Roboy/tss18-Stronger-Hand/README.md

# tss18-Stronger-Hand
This is the repository for the Bachelor Thesis of the Stronger Hand (Gripper)
