Roboy/tss18-Stronger-Hand/docs/SS18-StrongerHand-211218-1420.pdf

# Stronger Hand

## Requirements:

Global Goals:

Functional Grasping with moderate Dexterity ( more than only one mode of open-close)

High Grasping Force: should be able to carry things up to 10 kg

Compact design for the Gripper as a possible endeffector for Roboy

Requirements from the Roboy Project:

Usage of Electromotors for Actuation

Actuation transmission: Tendon-driven

Method: Iterative rapide Ptototyping with of the shelf components for saving time and money

3D Prinitng of the components

Time Constraint: 6 Months

## Inspirationen- State of the Art:

Comparison of Robotic Grippers | Examples
anthropomorphic research hands | underactuated | Design of a highly biomimetic anthropomorphic robotic hand towards artifical limb regeneration (Xu und Todorov) CATCH-919 Hand: (Zhang et al) Unipi Hand (Catalano) Pisa IIT/ Soft hand (Catalano) Pisa Soft IIT/ Soft Hand 2 (Santina)
| fully actuated | Awiwi-Hand (Grebenstein) Utah/ MIT Dextrous Hand (Jacobsen) DLR Hand 2 (Butterfass) Shadow Hand
anthropomorphic prostehtic hands underactuated | mostly underactuated full | Cyberhand (Carrozza) SPRING Hand (Carrozza) Towards the design of a prosthetic hand ( Laliberté)
| fully actuated | Otto Bock myoelectrics hand
industrial grippers | underactuated | SDM Hand ( Dollar and Howe) i-HY Hand (Odhner) modular open source 3D printed underactuated hand (Ma) Barret Hand Grasper (Townsend)
Concepts for Hand Design | Different possibilitys

actuation unit | location of actuator | Extrinic: Forearm intrinsic: Self-contained
| actuation mechanism | Pneumatic actuation Electromotors ....
| Number of Actuators: DOA | high Number: high "Dexterity vs high complexity and buly design low number: low "dexterity " vs. compact and easy controlable design
number of DOF to number of DOA | | DOA<DOF: underactuated: passive joints DOA=DOF: fully actuated: active joints
way of actuation transmission | Joints | mechanical joints anthropomorphic joints elastic couplings
| Actuation transmission | tendon-driven: for fully actuation and underactuation linkage: for underactuation motor-driven: for fully actuation

## From Global Goals to technical Requirements- Modelling of the physical Systems as a basis for the design process and evaluation:

## Kinematik-Modellierung:

From complex 21 DOF Modell to.....

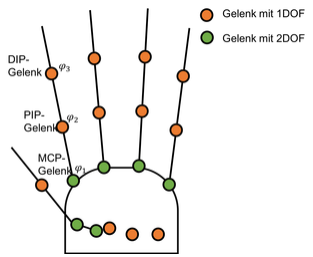
[picture p12: figure]

Functional Workspace: Optimized Taxonomy

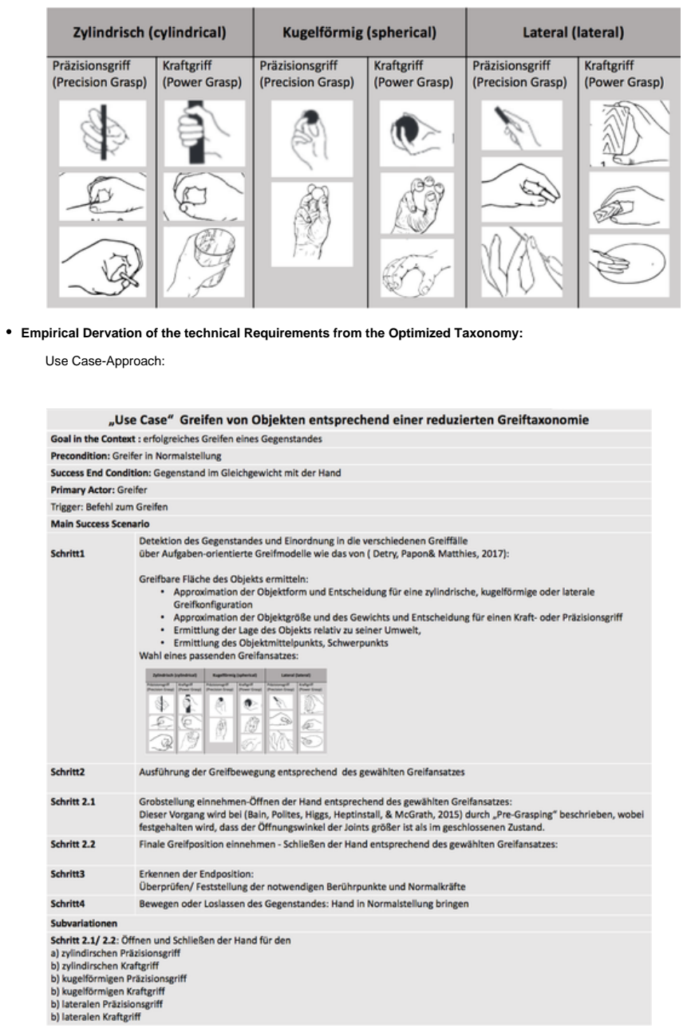
[picture p13: page 3]

Empirical Dervation of the technical Requirements from the Optimized Taxonomy:

Use Case-Approach:

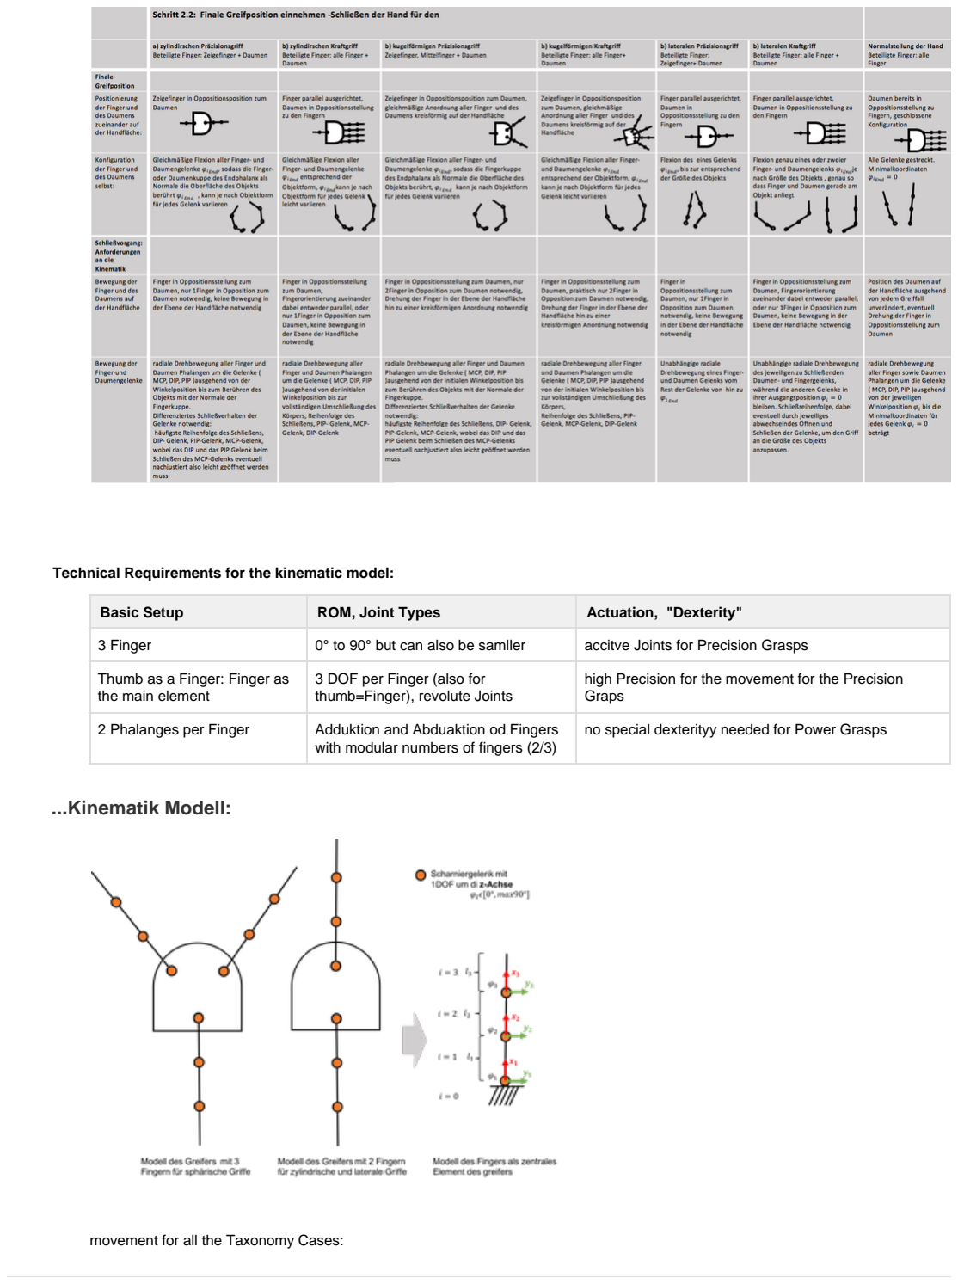
[picture p14: page 4]

Technical Requirements for the kinematic model:

Basic Setup | ROM, Joint Types | Actuation, "Dexterity"
3 Finger | 0° to 90° but can also be samller | accitve Joints for Precision Grasps
Thumb as a Finger: Finger as the main element | 3 DOF per Finger (also for thumb=Finger), revolute Joints | high Precision for the movement for the Precision Graps
2 Phalanges per Finger | Adduktion and Abduaktion od Fingers with modular numbers of fingers (2/3) | no special dexterityy needed for Power Grasps

## ...Kinematik Modell:

movement for all the Taxonomy Cases:

lateral Precision Grasp | lateral Power Grasp | cylindircal Precision Gras

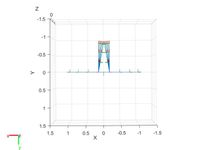
[picture p15: figure]

## Dynamik-Modellierung:

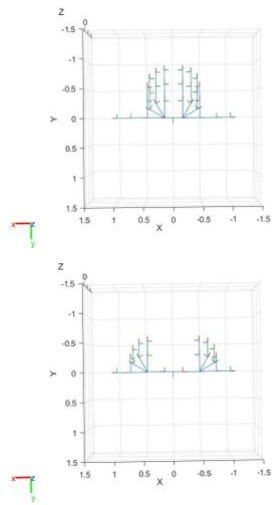
[picture p16: figure]

## Dynamical Modell of applying external Forces:

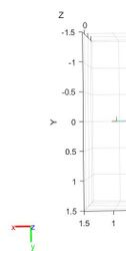
[picture p17: figure]
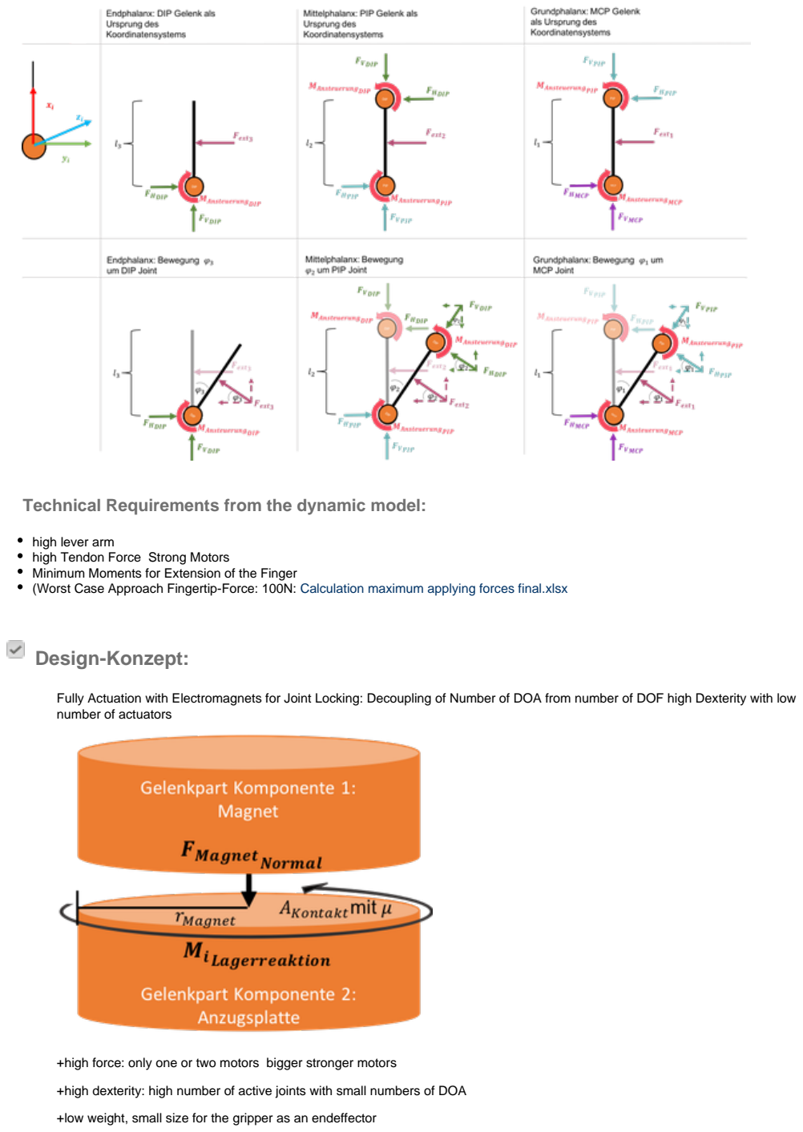
[picture p18: page 6]

## Technical Requirements from the dynamic model:

high lever arm
high Tendon Force Strong Motors
Minimum Moments for Extension of the Finger
(Worst Case Approach Fingertip-Force: 100N: Calculation maximum applying forces final.xlsx (https://devanthro.atlassian.net/wiki/download/attachments/260309073/Calculation%20maximum%20applying%20forces%20final.xlsx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)

## Design-Konzept:

Fully Actuation with Electromagnets for Joint Locking: Decoupling of Number of DOA from number of DOF high Dexterity with low number of actuators

+high force: only one or two motors bigger stronger motors

+high dexterity: high number of active joints with small numbers of DOA

+low weight, small size for the gripper as an endeffector

## Mathematical Modell: More Components Systems with Forces and Moments acting on it:

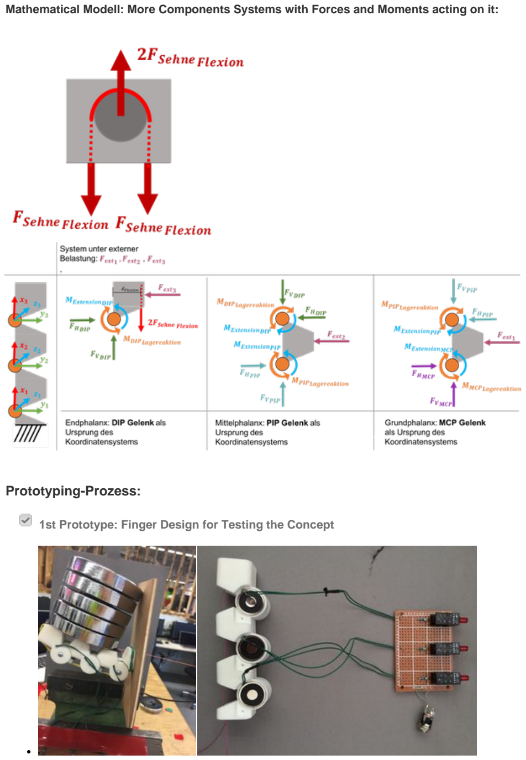
[picture p19: page 7]

## Prototyping-Prozess:

## 1st Prototype: Finger Design for Testing the Concept

CAD Path: Master Student Projects 18-18SS Stronger Hand 1_Prototyp 1
Prototyp 1-Dokumentation.docx (https://devanthro.atlassian.net/wiki/download/attachments/280559848/Prototyp%201-Dokumentation.docx?version=1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)

## 2nd Prototype: Imprvement of Finger Design and development of Gripper Design:

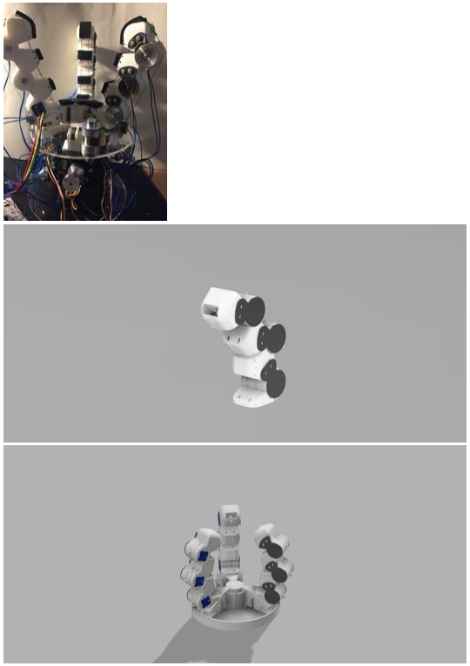
[picture p20: figure]

CAD Path: Master Student Projects 18-18SS Stronger Hand 2_Prototyp 2 Finger Mit Platte
Zweiter Prototyp.docx (https://devanthro.atlassian.net/wiki/download/attachments/280559848/Zweiter%20Prototyp.docx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)

Test Bench for Evaluation of the 2nd Prototype : Software, Electronics and Mechanical Hardware

## Design for Actuating the Gripper and getting Data from it

CAD Path: Master Student Projects 18-18SS Stronger Hand Test Bench Git repository: Stronger Hand

Test Bench_Evaluierung des Greifers.docx (https://devanthro.atlassian.net/wiki/download/attachments/280559848/Test%20Bench_Evaluierung%20des%20Greifers.docx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)

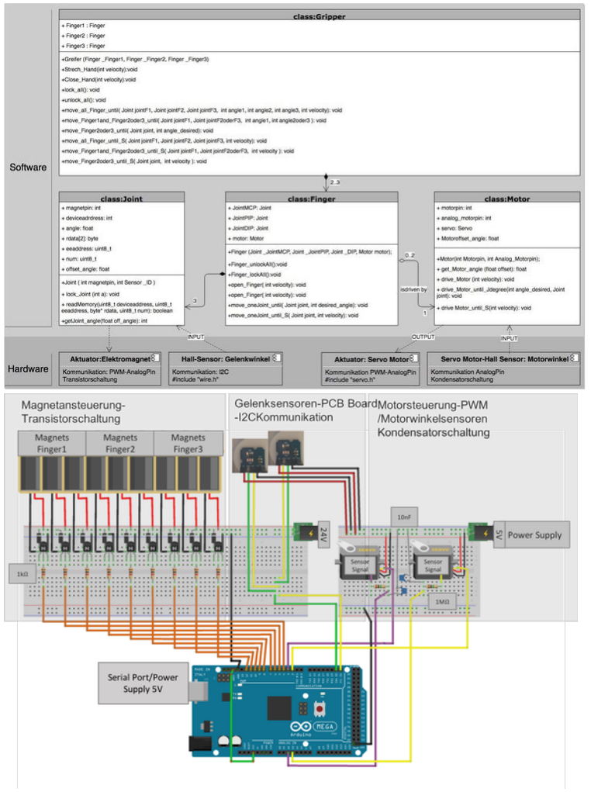
[picture p21: figure]

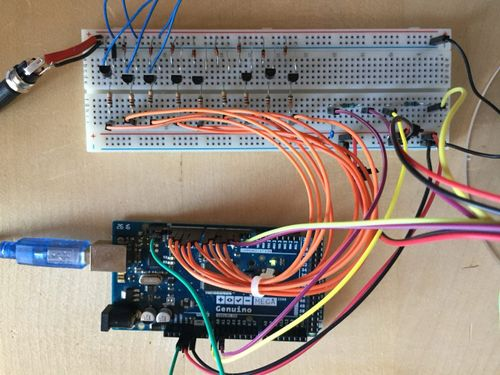
[picture p22: figure]

BOM-Maintenance _Final Version 08.10.2018.xlsx (https://devanthro.atlassian.net/wiki/download/attachments/259784776/BOM-Maintenance%20_Final%20Version%2008.10.2018.xlsx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)

# Final Evaluation

Verfiacation | Validation
| Finger

## Validation Gripper

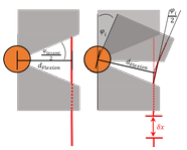
[picture p23: figure]

1.
2.

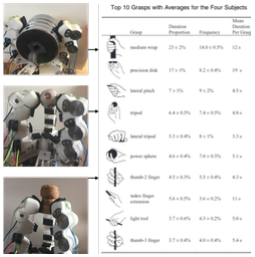
[picture p24: figure]

1.

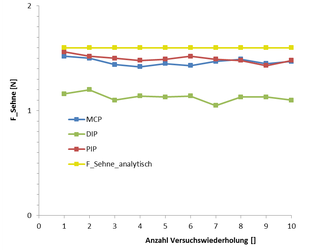
[picture p25: figure]

1.
2.
Precision of Movement Transmission: | Validation of the kinematics against the Taxonomy

Validation of the Grasping Performace ( Kinematics)

Against Taxonomy
Against Taxonomy from (Bullock)

Against a Set of Objects from the FFP Index from (Sureshbabu)

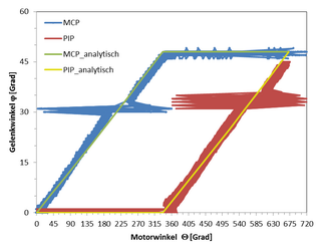
[picture p26: figure]

Precision of Force Transmission | Validation of the Fingertip Force against the Dynamic Modell

Validation of the Maximun Force of the Gripper (Kinetics)

Cylindircal Power Grasp 7kg
Spherical Power Graps 6kg

Electromagnets Mechanism-

Maximum Moment which can be applied on the System for keeping the Joint lockes

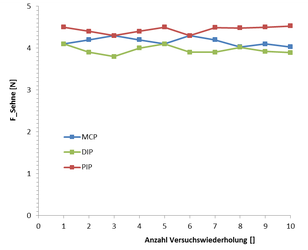
[picture p27: figure]

Electromagnets Mechanism-

Joint Position Precision for fast Switching of active Joints

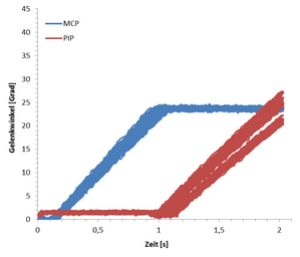
[picture p28: figure]
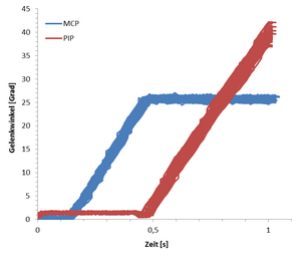
[picture p29: figure]

Robustness

## Manual- How to use the Gripper

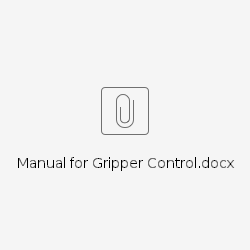
[picture p30: figure]
