Roboy/tss18-Stronger-Hand/cad/Prototyp 1_ Finger neu.stl

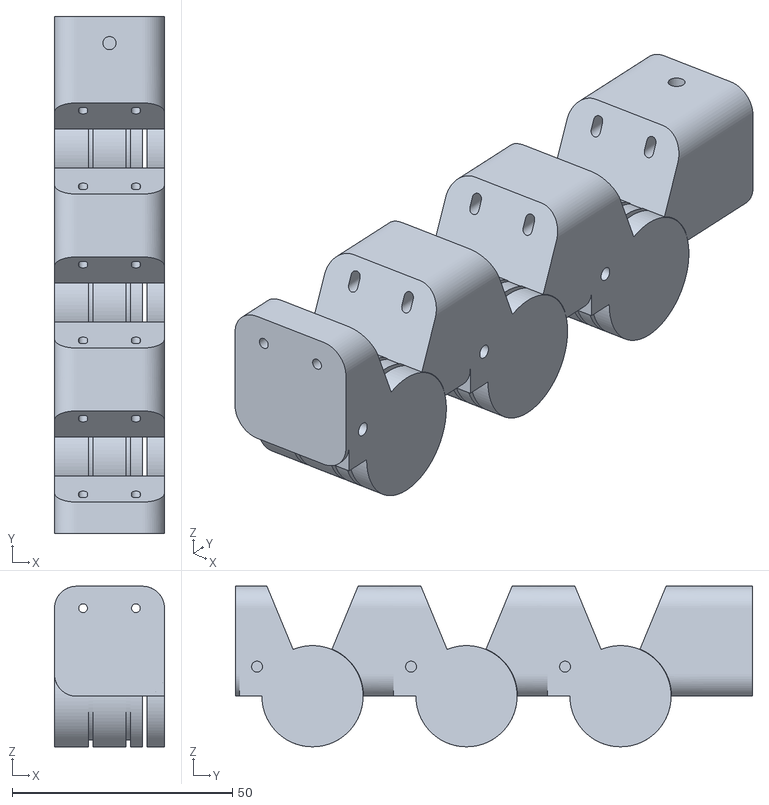
[picture p31: CAD file, 2018-12-21]
cad/Prototyp 1_ Finger neu.stl
25.0 x 117.5 x 36.5
