Roboy/tss18-Stronger-Hand/cad/Prototyp 2 Finger.stl

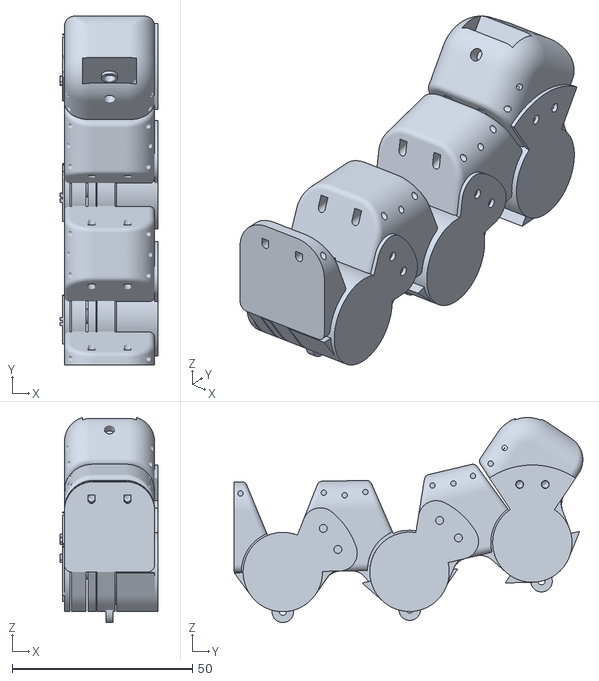
[picture p32: CAD file, 2018-12-21]
cad/Prototyp 2 Finger.stl
27.3 x 96.7 x 56.8
